Buntungjai/Self-Balancing-Two-Wheel-Robot/README.md

# Self-Balancing-Two-Wheel-Robot with PID Control & Sensor Fusion

Self Balancing Demo

https://youtu.be/95e5Ph7vr44

ก่อนที่จะได้หุ่นยนต์ทรงตัวเองนี้ ได้ทำหุ่นยนต์ต้นแบบมาก่อน <br>
ซึ่งได้แรงบันดาลใจจาก https://circuitdigest.com/microcontroller-projects/arduino-based-self-balancing-robot

โดยหน้าตาหุ่นต้นแบบจะ ทรงตัวไม่ได้และสายไฟ ยังยุ่งเหยิงดังรูปภาพด้านล่าง

<table border="0">
 <tr>
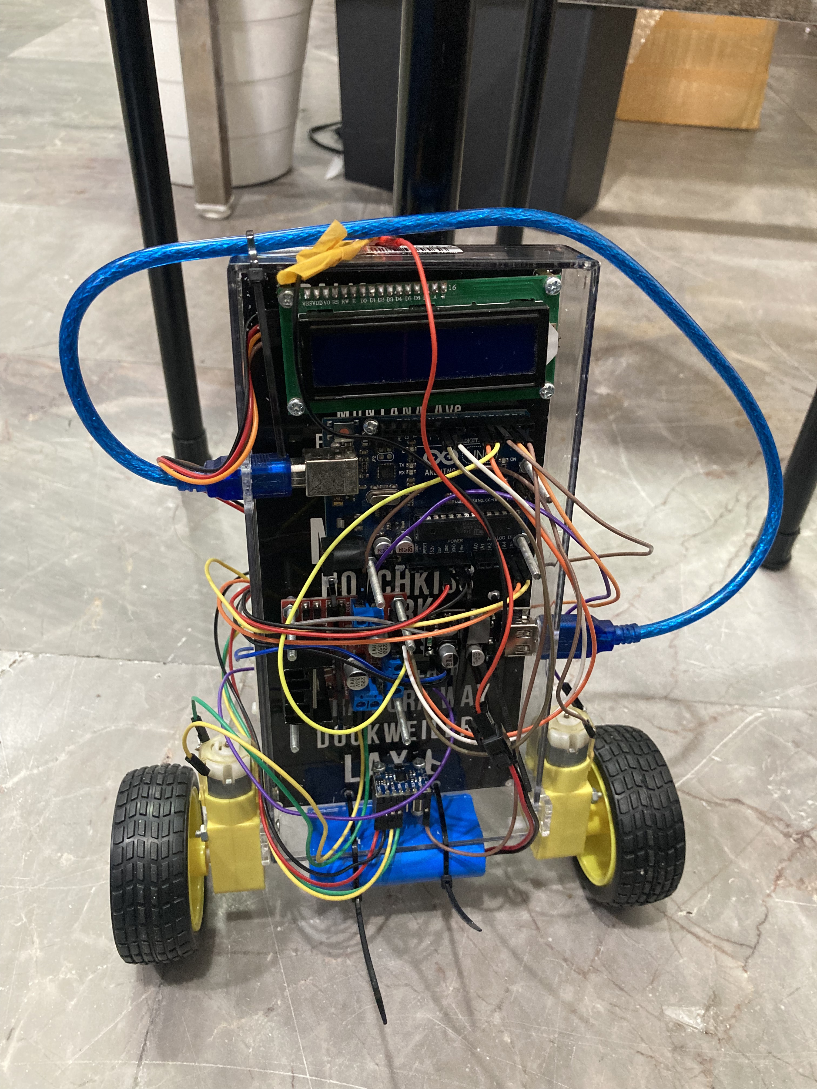
[picture p1: images/origin1.JPG]
    <td><br><p align="center">มุมมองด้านหน้า</p></td>
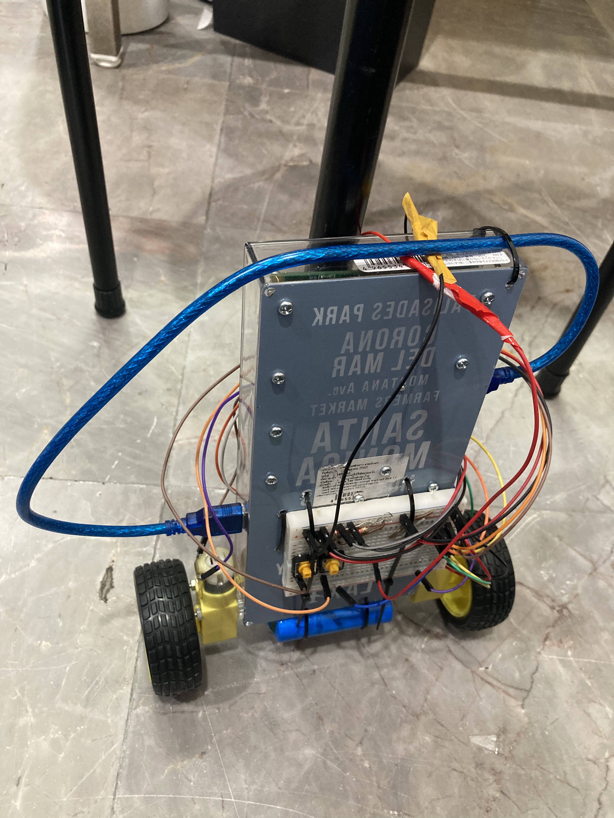
[picture p2: images/origin2.JPG]
    <td><br><p align="center">ใช้ปุ่มจูน PID</p></td>
 </tr>
 <tr>
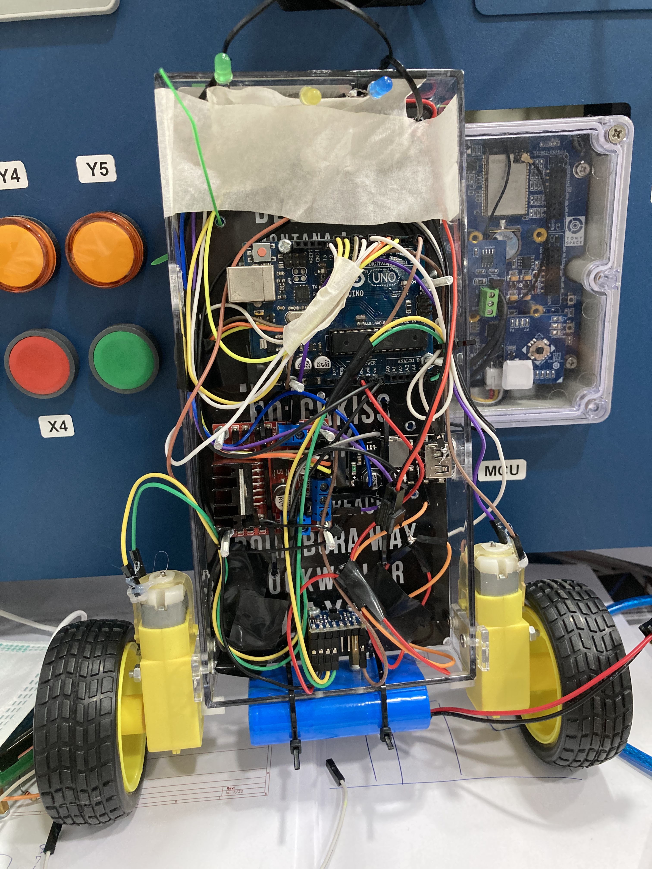
[picture p3: images/origin3.JPG]
    <td><br><p align="center">ใช้ LED บอกสถานะ</p></td>
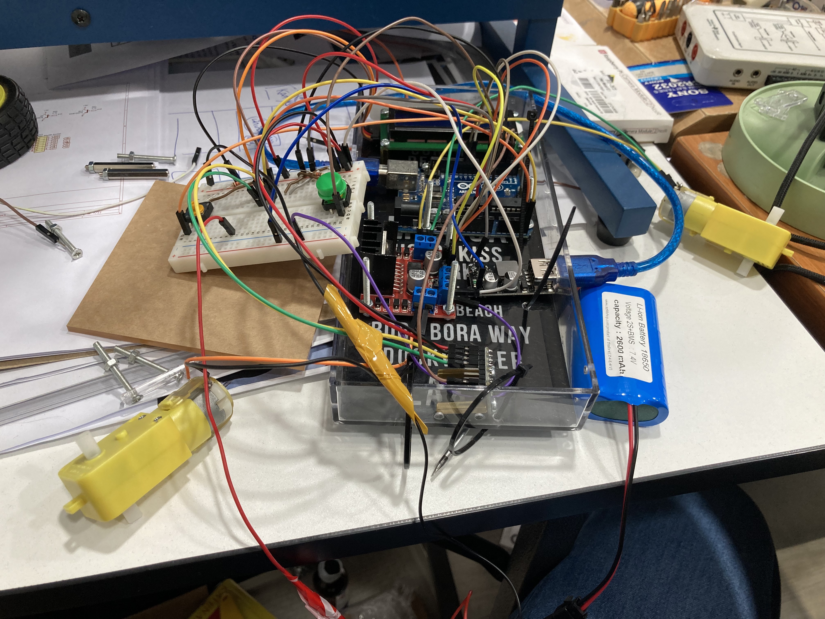
[picture p4: images/origin4.JPG]
    <td><br><p align="center">การเดินสายไฟ</p></td>
 </tr>
</table>

<p align="center">
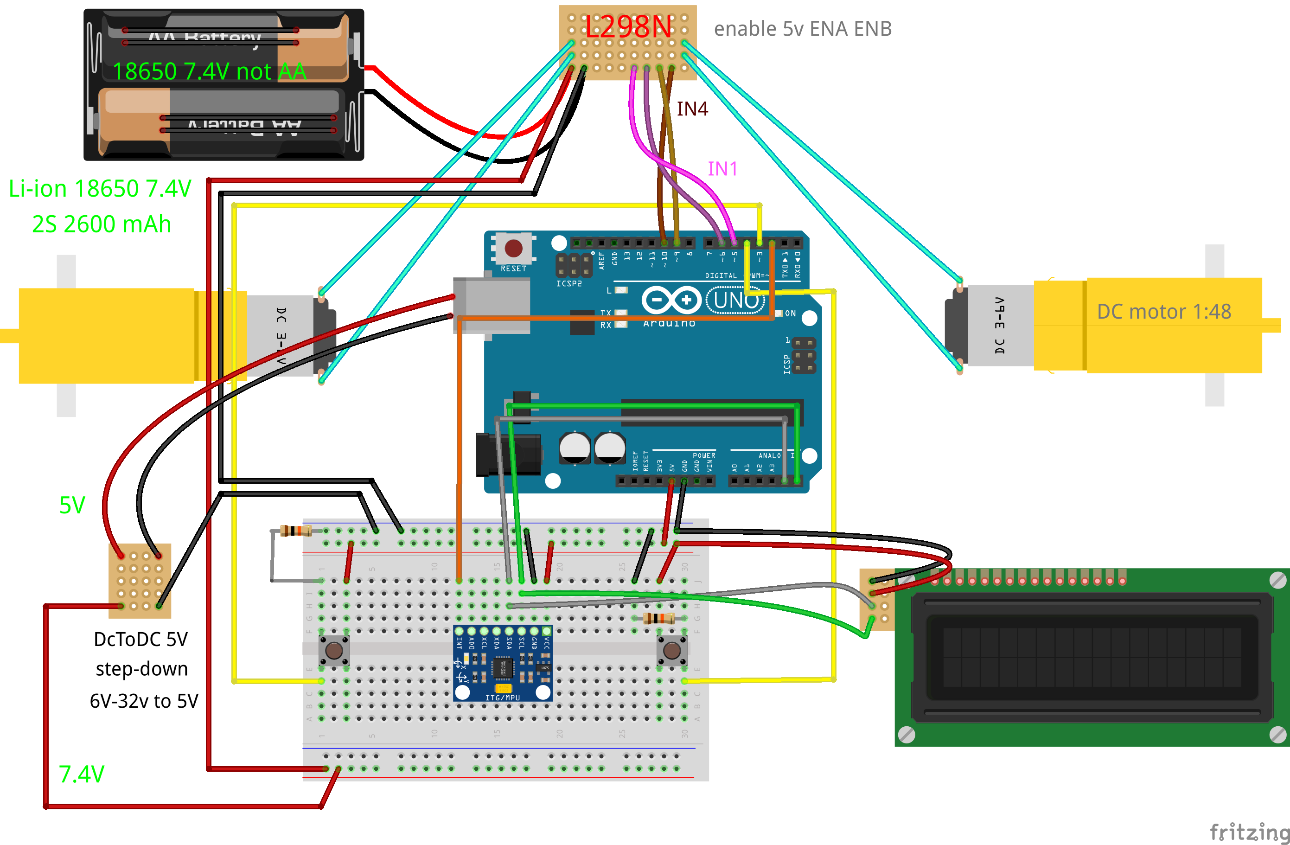
[picture p5: images/circuitVersion1.png]
  
</p>

ซึ่งอุปกรณ์ที่ใช้คือ <br>
Arduino UNO R3 <br>
มอเตอร์ DC gear motor อัตราทด 1:48 <br>
L298N Motor Driver Module <br>
MPU6050 <br>
ล้อสองข้าง <br>
7.4V Li-ion Battery <br>
สาย Jumper <br>
แผ่นอะคลิลิคแบบไม่สมดุล(จริงๆเป็นถาดวางของ) <br>
step down dc to dc <br>

<br>
สุดท้ายเลยต้อง ออกแบบใหม่
<br>

<h3> 🏗️ มีบางอุปกรณ์ที่เลือกใช้ใหม่ </h3>

<h4> 🛠️ การออกแบบโครงสร้าง </h4>
โครงทำจาก แผ่นอะคลิริค 10x10 มีประมาณ 6แผ่น <br>
โครงสร้างใหม่คำนวณการกระจายน้ำหนักและจุดศูนย์ถ่วง Center of Mass(CoM) <br>
ลดค่า Moment of Inertia (I) ทำให้การจูน PID ทำได้ง่ายขึ้น<br>
การคำนวณ CoM ให้พอเหมาะไม่สูงและไม่ต่ำเกินไป <br>ถ้าสูง >> (ควบคุมง่ายแต่ช้า) <br>ถ้าต่ำ >> (เร็วแต่ล้มไว เหมือนหุ่นยนต์ตัวแรกที่ผมทำเอาแบตเตอรี่ไว้ล่างสุด) <br> แต่ถ้า CoM สูงเกินมอเตอร์ทำงานหนัก CoM ต่ำเกินระบบไว จูน PID ยาก<br>
ลด Moment of Inertia โดยการนำมวลหนักๆเข้าใกล้แกนล้อให้มากที่สุด <br>

<h4> ⚙️การเลือกมอเตอร์ใหม่ </h4>
จาก มอเตอร์ DC gear motor อัตราทด 1:48 เปลี่ยนเป็นมอเตอร์ JGA25-370 DC6V170RPM<br>
JGA25-370 เกียร์เป็นเหล็ก metal gearbox แข็งกว่า TT motor ความทนทานสูงกว่าหุ่นยนต์รับน้ำหนักได้มากขึ้น <br>
JGA25-370 ให้แรงบิดที่มากกว่า TT motor <br>
JGA25-370 ใช้รุ่นที่รองรับ encoder ถ้าเป็น TT Motor ต้องติดแยกเอง <br>
ล้อขนาด 6.5 cm (เส้นผ่านศูนย์กลางรวมยางแล้ว)<br>

<h4>⚡ การเลือกมอเตอร์ไดเวอร์ใหม่ </h4>
ไดเวอร์ TB6612FNG ดีกว่า L298N หลายด้าน <br>
รองรับกระแสสูงสุดได้ถึง 3A สำหรับ L298N 2A <br>
แรงดันตกคร่อม ต่ำกว่า ทำให้ มอเตอร์แรงกว่า <br>
TB6612FNG ใช้ MOSFET L298N ใช้ ไบโพลาร์ทรานซิสเตอร์ ทำให้แรงดันตกคร่อมของ TB6612FNG น้อยกว่า <br>
ความร้อนน้อยกว่า ไม่ต้องติดฮีตซิงก์ ประหยัดพื้นที่มาก <br>

<h4> การเลือก stepdown dc to dc ใหม่ </h4>
LM2596 แปรงแรงดัน DC to DC รองรับกระแสได้สูง Peak 3A ความร้อนน้อย noise น้อย<br>

<h4>  🧵 การ Wire สายไฟ</h4>
มีความสำคัญมาก ! จากหุ่นยนต์ตัวแรก จะค้างบ่อยและชอบรีเซตตัวเองสัญญาณไม่เสถียร <br>
ซึ่งสายขนาดเล็ก jumper ที่ยาวถึง 20 cm ทำให้แรงดันลดลงและถูก noise รบกวนมาก <br>
ทำการปรับเป็นสายที่ใหญ่ขึ้นคือ AWG 24 (ไม่เลือกสายที่ใหญ่กว่านี้เพราะจะบัดกรีลงไดเวอร์ยาก) <br>
แต่สำหรับสายที่ต่อกับเซนเซอร์ใช้ jumper ได้ และสายสัญญาณพวก INA INB PWM ของมอเตอร์ไดเวอร์ <br>
<br>
แบตเตอรี่์ li-ion 18650 2S+BMS 7.4V 2600mAh (เหมือนเดิม)<br>
เซนเซอร์ mpu6050 (เหมือนเดิม) <br>

<table border="0">
 <tr>
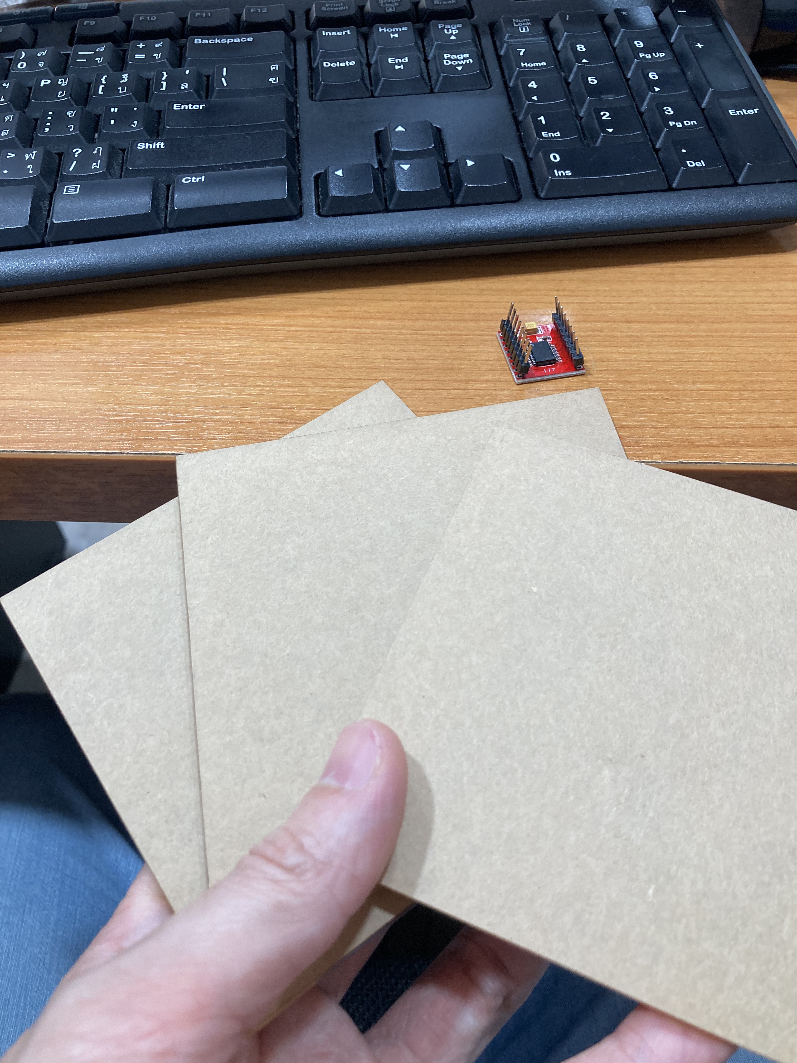
[picture p6: images/selfB1.JPG]
    <td><br><p align="center">อะคลิลิค 10x10 </p></td>
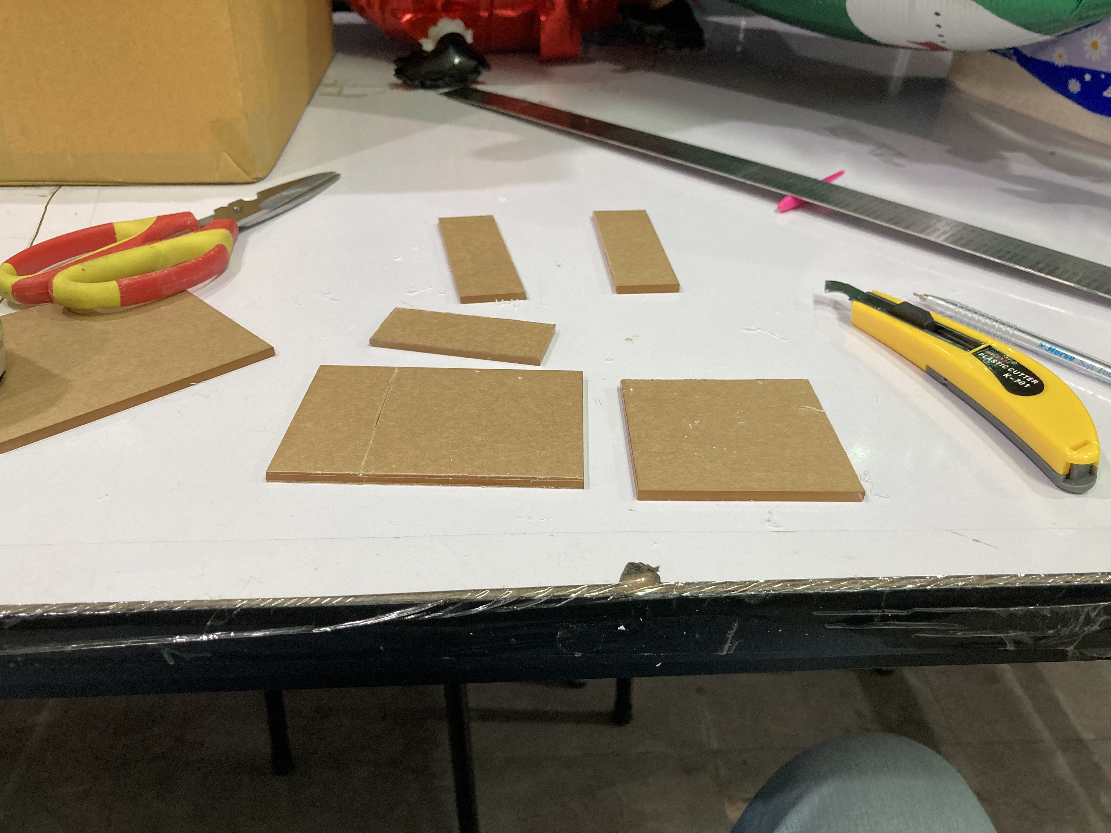
[picture p7: images/selfB2.JPG]
    <td><br><p align="center">คัตเตอร์กรีดและหัก</p></td>
 </tr>
 <tr>
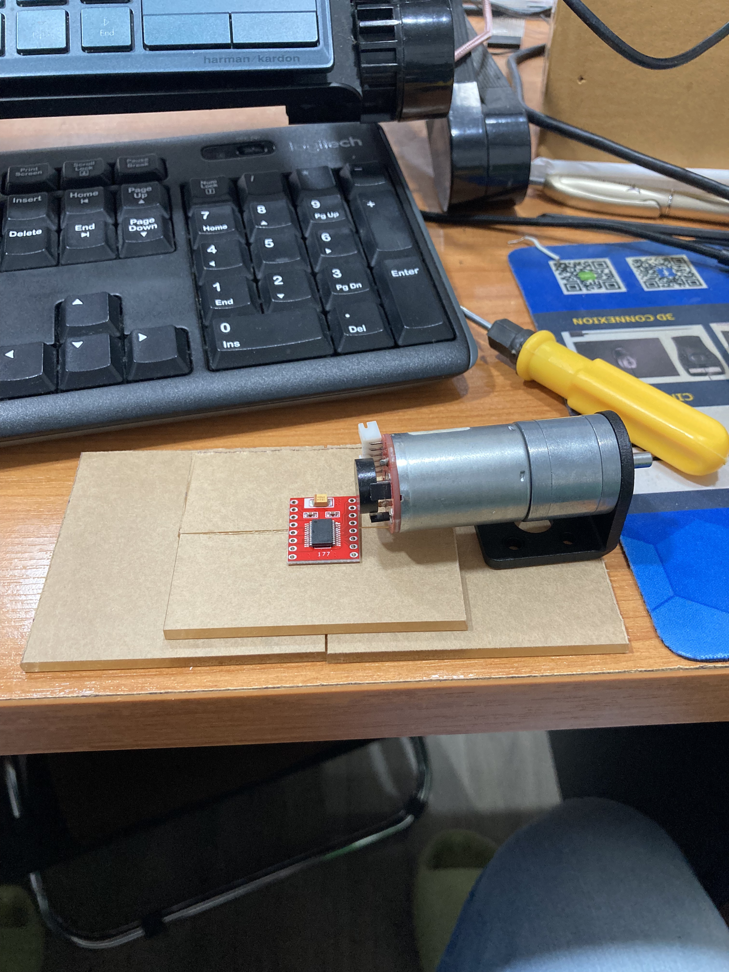
[picture p8: images/selfB3.JPG]
    <td><br><p align="center">จัดตำแหน่งชั้น 1</p></td>
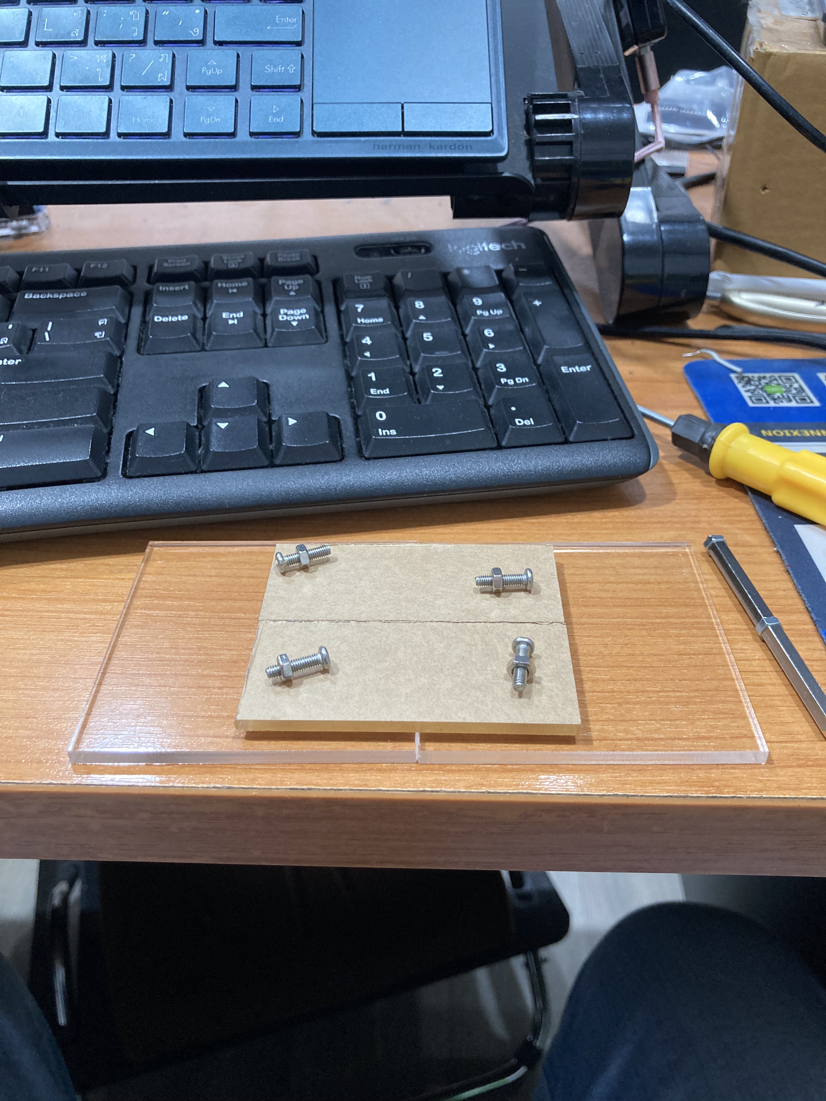
[picture p9: images/selfB4.JPG]
    <td><br><p align="center">ยึดน๊อต</p></td>
 </tr>
</table>

<table border="0">
 <tr>
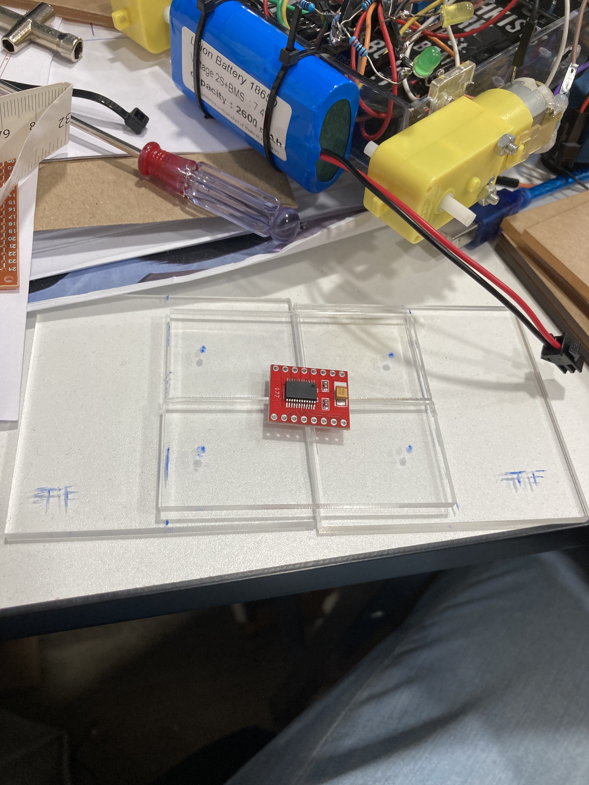
[picture p10: images/selfB5.JPG]
    <td><br><p align="center">ตำแหน่งการเจาะรู </p></td>
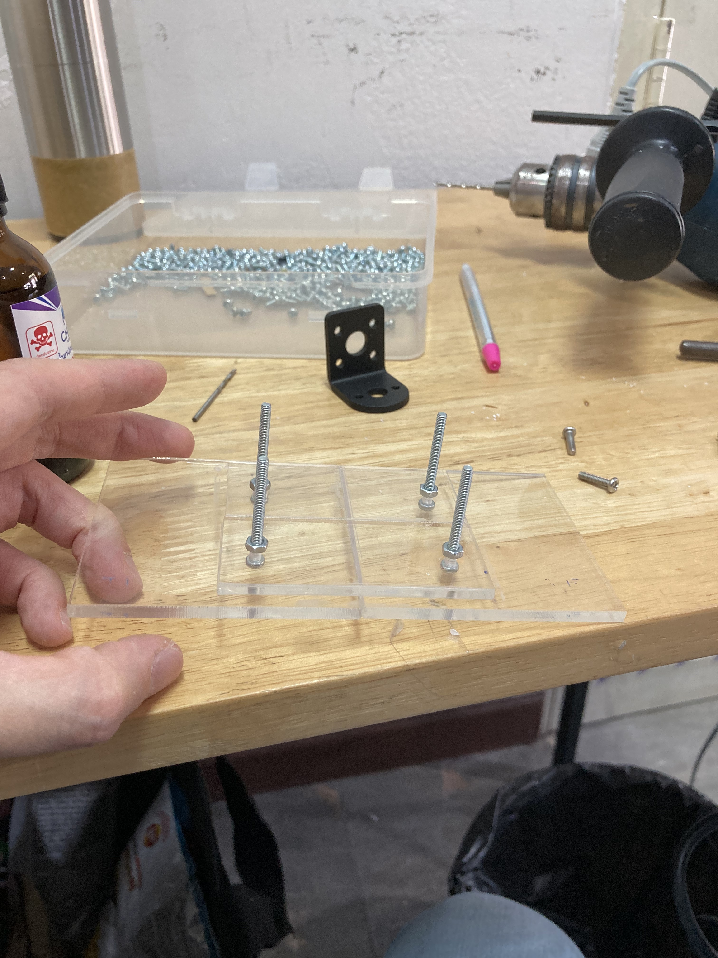
[picture p11: images/selfB6.JPG]
    <td><br><p align="center">ต่อชั้น 2</p></td>
 </tr>
 <tr>
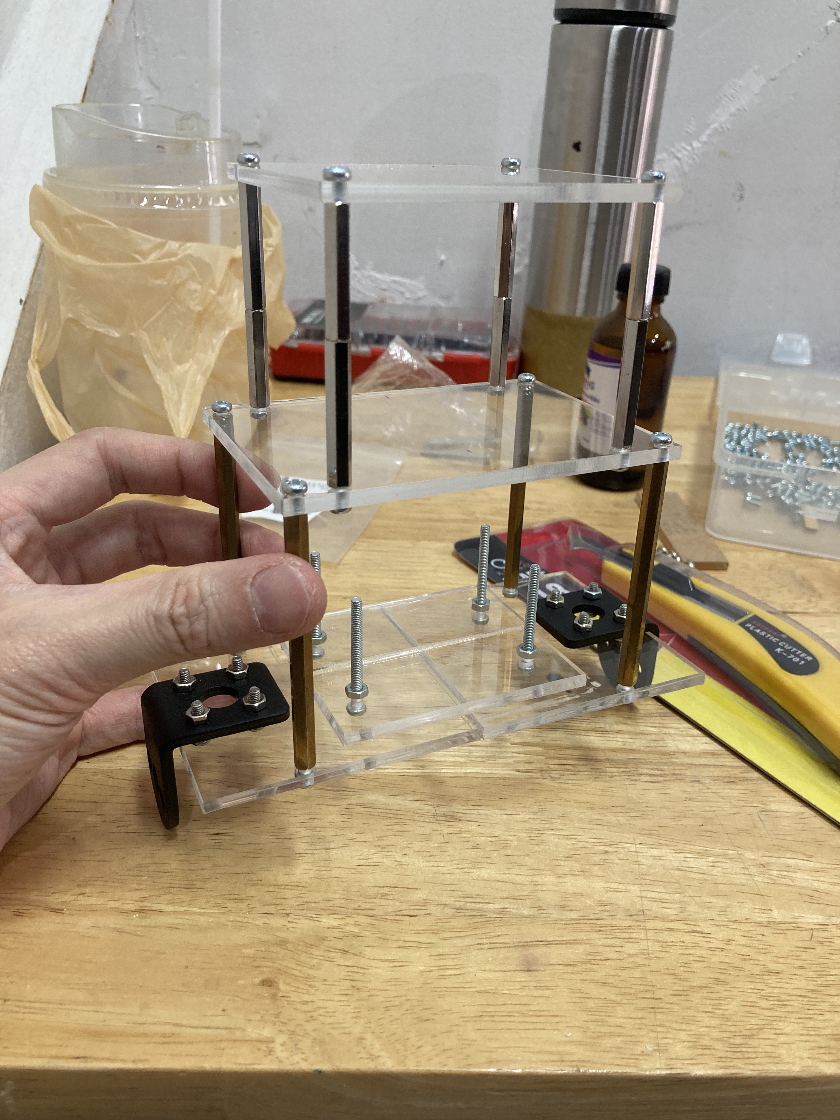
[picture p12: images/selfB7.JPG]
    <td><br><p align="center">ต่อชั้น 3</p></td>
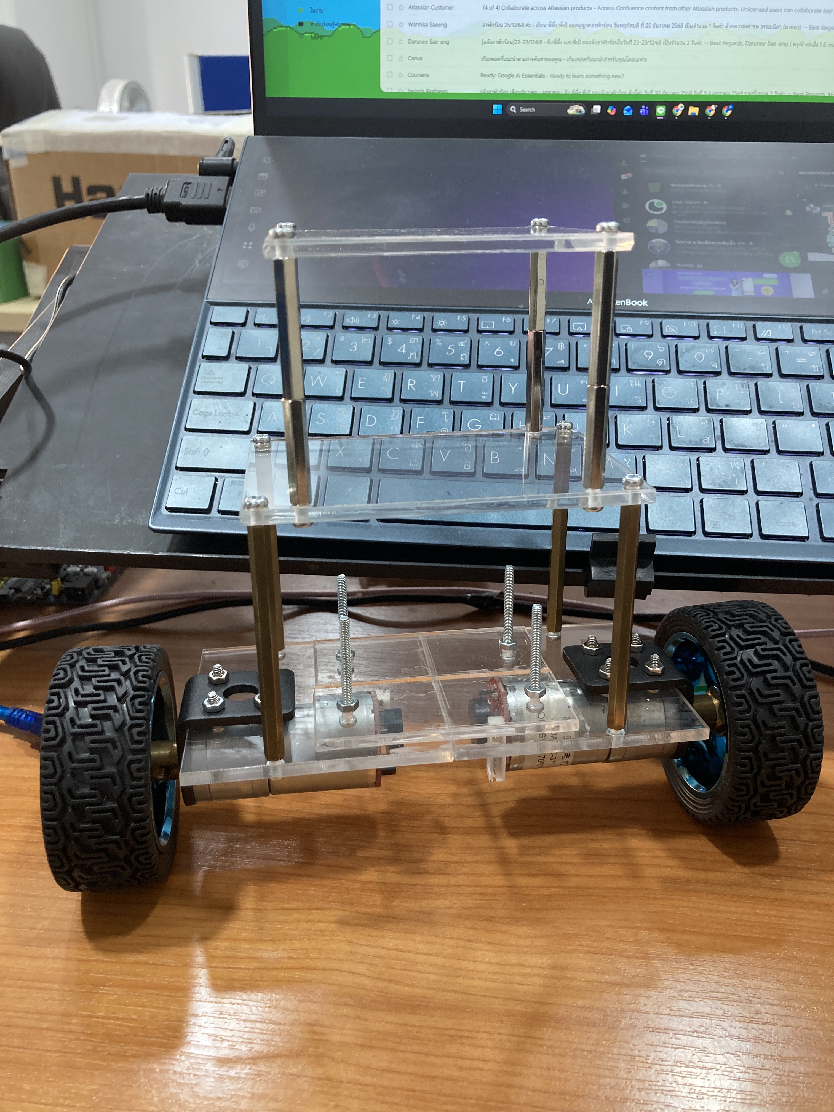
[picture p13: images/selfB8.JPG]
    <td><br><p align="center">ใส่ล้อและมอเตอร์</p></td>
 </tr>
</table>

<table border="0">
 <tr>
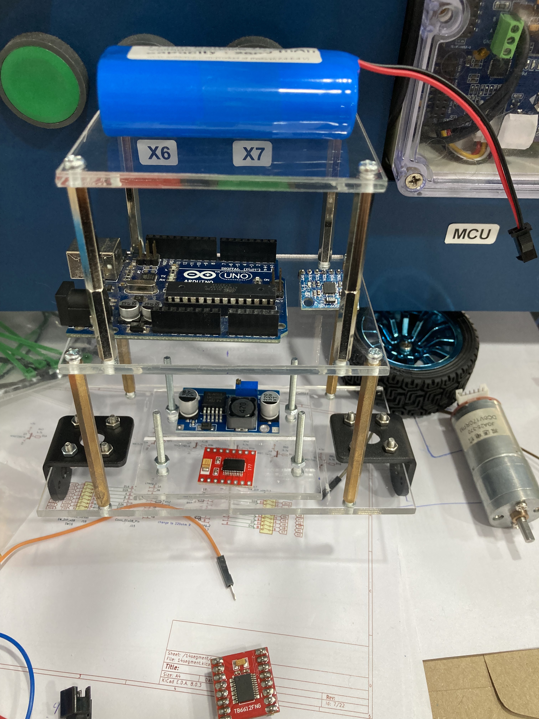
[picture p14: images/selfB9.JPG]
    <td><br><p align="center">ทดลองวางอุปกรณ์ </p></td>
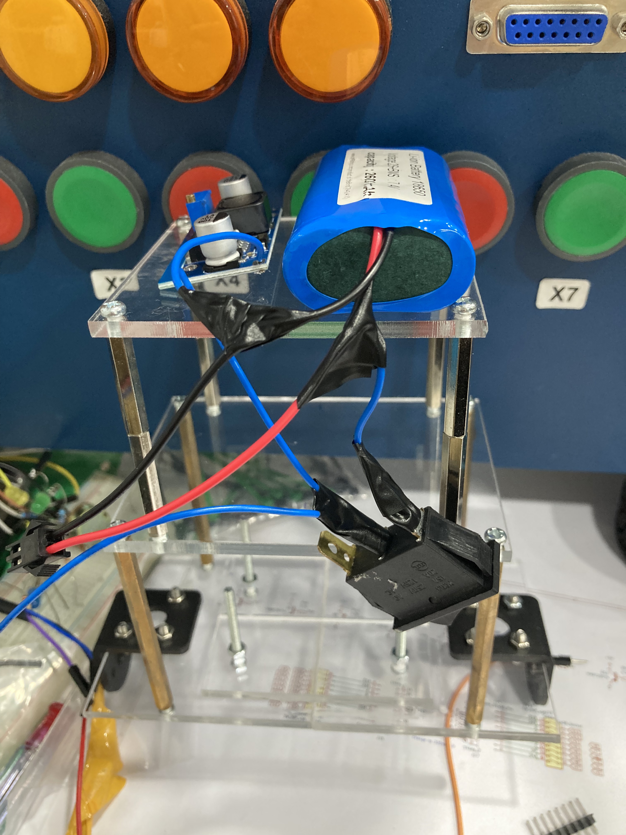
[picture p15: images/selfB10.JPG]
    <td><br><p align="center">ทำสวิตช์ เปิด ปิด</p></td>
 </tr>
 <tr>
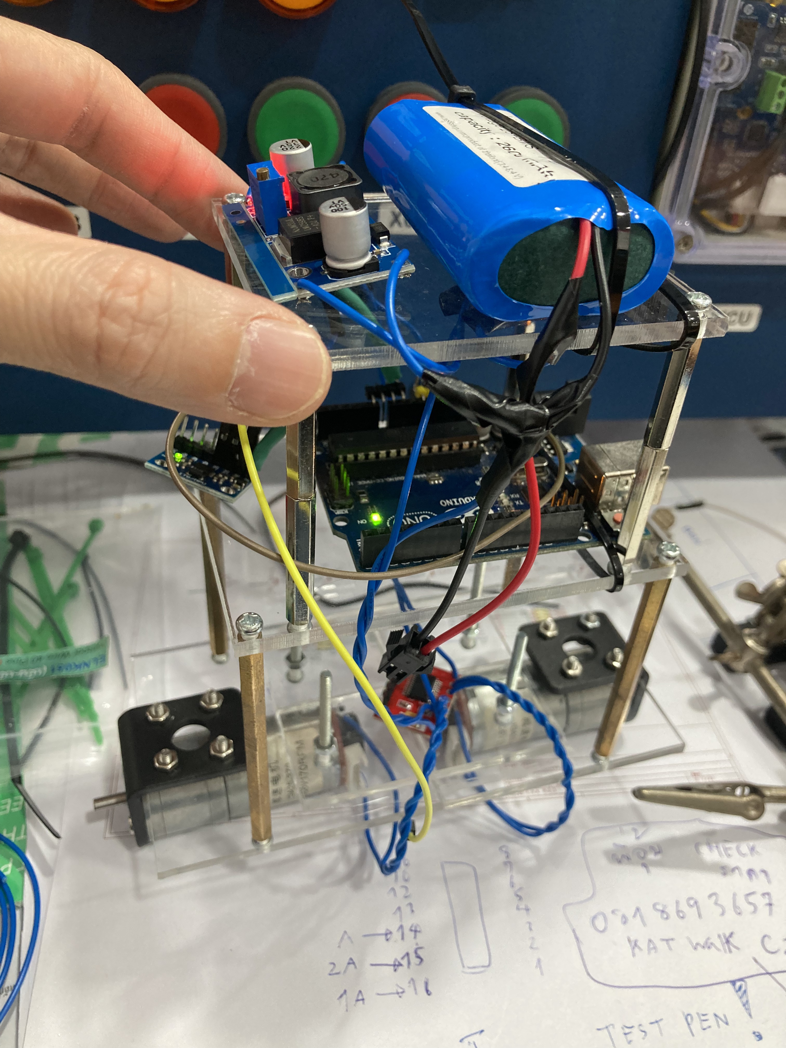
[picture p16: images/selfB11.JPG]
    <td><br><p align="center">เดินสายไฟ</p></td>
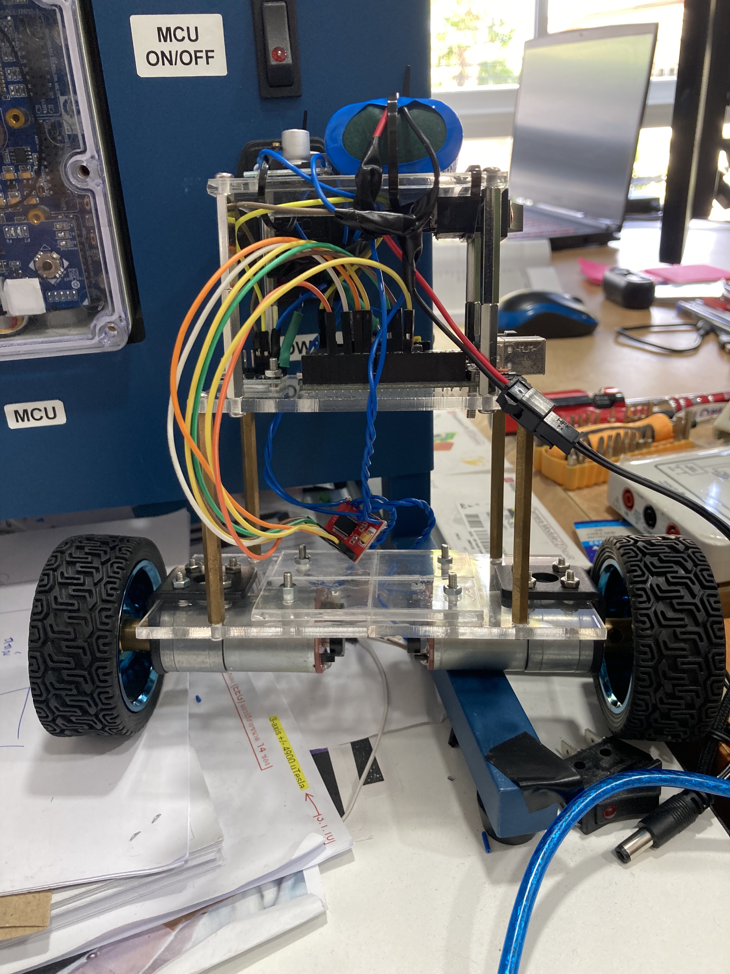
[picture p17: images/selfB12.JPG]
    <td><br><p align="center">ต่อสาย jumper</p></td>
 </tr>
</table>
<p align="center">
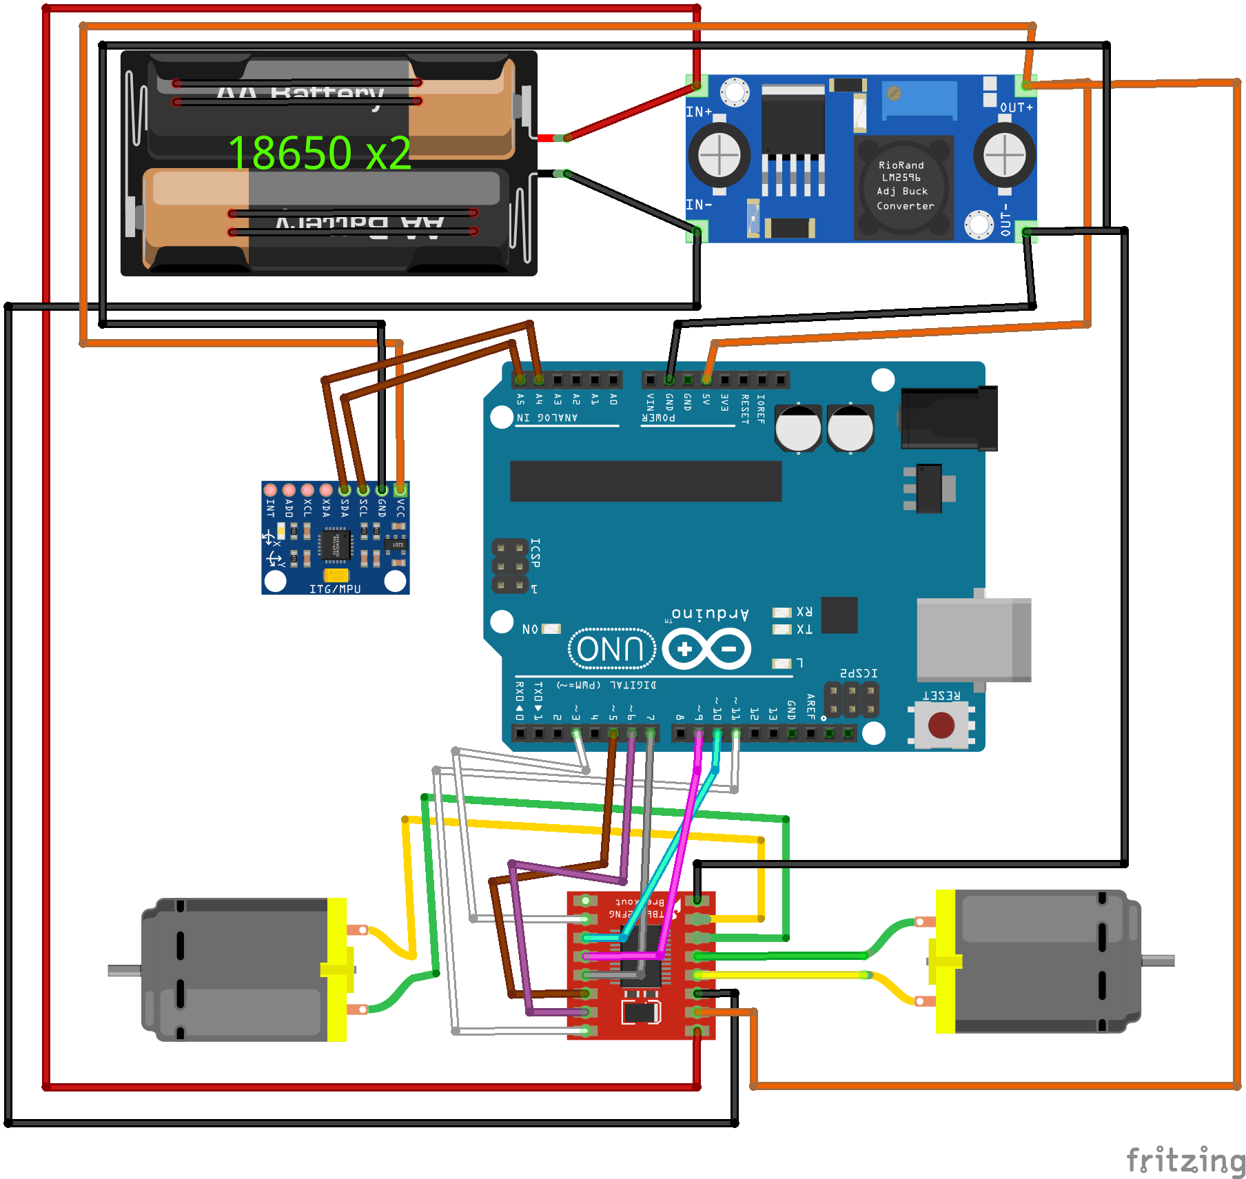
[picture p18: images/circuitVersion2.png]
  
</p>

สำหรับการต่อ encoder มีการปรับพินจากภาพด้านบน และมีการต่อเพิ่มจากมอเตอร์ทั้งสองอย่างล่ะ 4 เส้น คือ Vcc, pulseA,pulseB ,GND ซึ่งส่วนปลายซ้ายขวาของ connector คือ M+ M- ที่ต่อเข้ากับมอเตอร์ไดเวอร์
<p align="center">
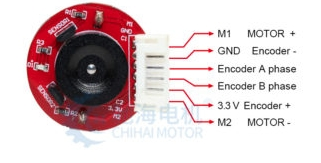
[picture p19: images/encoder.jpg]
  
</p>
ภาพตัวอย่างลำดับพิน ซึ่งจริงๆใช้ 5v สำหรับ encoder

## ⚙️ การจูน PID (PID Tuning Process)

การหาค่าที่เหมาะสมเพื่อให้หุ่นยนต์ทรงตัวได้นิ่งที่สุด มีขั้นตอนดังนี้:

### 🔹 STEP 1: $K_p$ (Proportional)
* **Action:** ค่อยๆ เพิ่มค่า $K_p$ จนกระทั่งหุ่นยนต์เริ่มสั่นไปมาและเด้งกลับได้เอง
* **Fine-tuning:** จากนั้นให้ลดค่าลงเล็กน้อย จนกระทั่งหุ่นยนต์เกือบจะทรงตัวได้ด้วยมือของเรา (เกือบจะ Balance ได้เอง)

### 🔹 STEP 2: $K_d$ (Derivative)
* **Action:** ค่า $K_d$ จะทำหน้าที่เสมือน **"เบรก"** เพื่อลดการโอเวอร์ชูตก่อนจะถึงจุด Setpoint
* **Caution:** ⚠️ หากใส่ค่านี้มากเกินไป จะทำให้หุ่นยนต์เกิดการสั่นสะเทือนถี่ๆ (High-frequency oscillation)

### 🔹 STEP 3: $K_i$ (Integral)
* **Action:** ใช้จัดการกับ **Steady State Error** เพื่อให้หุ่นยนต์เข้าสู่จุดสมดุลได้แม่นยำที่สุด
* **Note:** เนื่องจากมีการกำหนด *Sample Time* ในโค้ด อาจต้องเพิ่มค่า $K_i$ ไปจนถึงหลักร้อยเพื่อให้เห็นผล

---

### 🚀 Conclusion & Improvement
สุดท้ายแล้ว แม้จะจูน PID ได้ดีแค่ไหน **"การมี Encoder"** เข้ามาช่วยจัดการตำแหน่ง (Position Control) จะช่วยให้หุ่นยนต์นิ่งและสู้แรงผลักได้ดีกว่าการใช้แค่ IMU เพียงอย่างเดียว

## 🧠 รายละเอียดการประมวลผล (Technical Note)
ในโปรเจกต์นี้ ผมเลือกใช้ความสามารถของ DMP (Digital Motion Processor) ผ่านไลบรารี I2Cdevlib ของ Jeff Rowberg เพื่อยกหน้าที่การคำนวณ Sensor Fusion ที่ซับซ้อนออกจากหน่วยประมวลผลหลัก (Arduino MCU) ส่งผลให้ระบบสามารถประมาณค่ามุมองศาได้ด้วยความถี่สูง (High-frequency) และมีความหน่วงต่ำ (Low-latency) ซึ่งจำเป็นอย่างมากสำหรับระบบควบคุมการทรงตัวอัตโนมัติ

## 🙏 กิตติกรรมประกาศ (Acknowledgements)
โปรเจกต์นี้มีการใช้งานไลบรารีโอเพนซอร์ส (Open-source libraries) ดังนี้:

I2Cdevlib โดย Jeff Rowberg: ขอขอบคุณเป็นอย่างสูงสำหรับผลงานอันยอดเยี่ยมในการพัฒนาการเชื่อมต่อ MPU6050 DMP (Digital Motion Processor) ซึ่งมีส่วนสำคัญอย่างยิ่งที่ทำให้การคำนวณค่าความเอียง (Tilt estimation) ในโปรเจกต์นี้มีความแม่นยำสูง
