Buntungjai/Self-Balancing-Two-Wheel-Robot/MPU6050/examples/MPU6050_DMP6_using_DMP_V6.12/MPUplane/data/biplane.obj

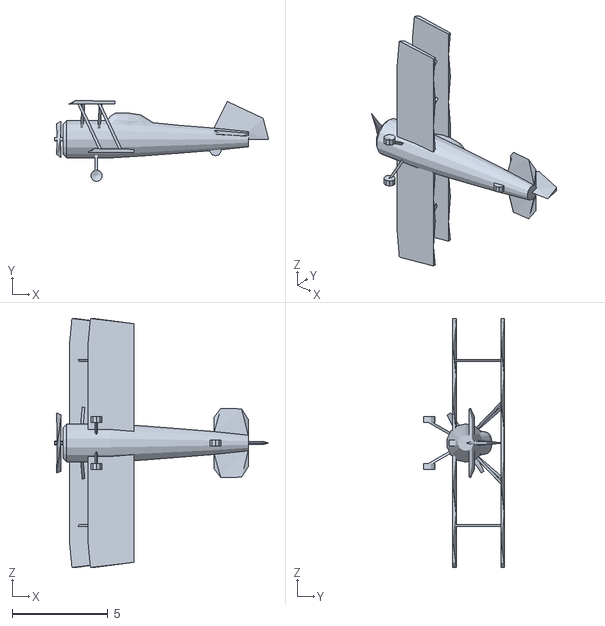
[picture p21: CAD file, 2026-01-22]
MPU6050/examples/MPU6050_DMP6_using_DMP_V6.12/MPUplane/data/biplane.obj
11.2 x 4.23 x 13.0
